robertpuccinelli/PCBs/(commit log)

2018-04-16 initialized repo
    [XC7Z035_universal.kicad_pcb, XC7Z035_universal.sch]
2018-04-21 edited XC7Z035 and biofilms
    [XC7Z035_universal.kicad_pcb, XC7Z035_universal.sch, routing_board.kicad_pcb, routing_board.sch]
2018-04-25 drafted v1 of biofilms PCB
    [routing_board.csv, routing_board.sch]
2018-04-27 finalized v1 of biofilms PCB
    [_saved_routing_board.sch, routing_board.csv, routing_board.kicad_pcb]
2018-05-10 finalized v2 of biofilms PCB
    [_saved_routing_board.sch, adapter_board_BOM_20180427.csv, adapter_board_BOM_20180430.csv, routing_board.csv, routing_board.kicad_pcb, routing_board.sch]
2018-06-18 added in-situ prep pcb
    [in_situ_prep.kicad_pcb, in_situ_prep.sch]
2018-06-25 added capper decapper motor schematic
    [MotorDriverBoard.kicad_pcb, MotorDriverBoard.sch]
2018-09-05 Capper Decapper added with custom components
    [MotorDriverBoard.sch]
2018-09-08 converted to KiCAD 5
    [Capper Decapper.kicad_pcb, Capper Decapper.sch, MotorDriverBoard-2018-09-05-15-03-28.sch, _saved_Capper Decapper.sch]
2018-09-10 complete 1st draft of capper/decapper PCB
    [Capper Decapper.kicad_pcb, Capper Decapper.sch, _saved_Capper Decapper.sch]
2018-09-20 PWM capper decapper board
    [2-Layer PCB-Capper Decapper.kicad_pcb, 4-Layer PCB-Capper Decapper.kicad_pcb, Capper Decapper.kicad_pcb, Capper Decapper.sch, Circuit Simulator.kicad_pcb, Circuit Simulator.sch]
2018-10-05 Capper/Decapper HW Control Board Rev A
    [Capper Decapper.kicad_pcb, Capper Decapper.sch]
2018-10-09 AND gate updated, ordered
    [Capper Decapper.kicad_pcb, Capper Decapper.sch]
2018-12-13 Capper Decapper solenoid correction and solder dispensing files
    [Capper Decapper Solenoid Correction.kicad_pcb, Capper Decapper Solenoid Correction.sch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]
2019-05-16 Directory update
    [Capper Decapper Pneumatics Circuit.kicad_pcb, Capper Decapper Pneumatics Circuit.sch, Capper Decapper.csv, Capper Decapper.sch]
2020-02-26 Update PCBs, Add autocapper board
    [2-Layer PCB-Capper Decapper.kicad_pcb, 4-Layer PCB-Capper Decapper.kicad_pcb, Capper Decapper Pneumatics Circuit.kicad_pcb, Capper Decapper Pneumatics Circuit.sch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]
2020-02-27 Capper Decapper REV B on OSHPark
    [MotorDriverBoard_v2-B_Cu.gbr, MotorDriverBoard_v2-B_Mask.gbr, MotorDriverBoard_v2-B_Paste.gbr, MotorDriverBoard_v2-B_SilkS.gbr, MotorDriverBoard_v2-Edge_Cuts.gbr, MotorDriverBoard_v2-F_Cu.gbr, MotorDriverBoard_v2-F_Mask.gbr, MotorDriverBoard_v2-F_Paste.gbr]
2020-02-28 Update schematic
    [MotorDriverBoard_v2.sch]
2020-03-04 Add printer, global IoT, and Nucelo test boards
    [Laser Proximity Sensor.kicad_pcb, Laser Proximity Sensor.sch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]
2020-03-04 Add capper v2 corrections
    [MotorDriverBoard_v2-B_Cu.gbr, MotorDriverBoard_v2-B_Mask.gbr, MotorDriverBoard_v2-B_Paste.gbr, MotorDriverBoard_v2-B_SilkS.gbr, MotorDriverBoard_v2-Edge_Cuts.gbr, MotorDriverBoard_v2-F_Cu.gbr, MotorDriverBoard_v2-F_Mask.gbr, MotorDriverBoard_v2-F_Paste.gbr]
2020-03-10 Update R1 design files
    [M1_STM32F4.kicad_pcb, M1_STM32F4.sch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]
2020-05-18 Add P1 Rev A, update R1 files, add initial M1, add gerber2graphtec
    [D1_DisplayInterface.sch, D1_ILI6122_FT5446.kicad_pcb, D1_ILI6122_FT5446.sch, D1_SST39VF3201C.sch, D1_STM32F429.sch, M1_STM32F4.kicad_pcb, M1_STM32F4.sch, P1_FT231X.csv]
2020-05-21 P1 Programmer Rev A
    [P1_FT231X.kicad_pcb, P1_FT231X.sch]
2020-05-21 Update LEDs on P1 3D model
    [P1_FT231X.kicad_pcb, P1_FT231X.sch]
2020-05-21 Initial D1, R1 Rev B
    [D1_DisplayInterface.sch, D1_SST39VF3201C.sch, D1_STM32F429.sch, R1_SIM868.kicad_pcb, R1_SIM868.sch]
2020-05-22 Corrected doubled symbol issue on R1
    [R1_SIM868.kicad_pcb, R1_SIM868.sch]
2020-05-24 Update P1 Rev B, R1 Rev B, D1 Rev A
    [D1_DisplayInterface.sch, D1_ILI6122_FT5446.sch, D1_SST39VF3201C.sch, D1_STM32F429.sch, Display_Module.sch, P1_FT231X.kicad_pcb, P1_FT231X.sch, R1.sch]
2020-05-24 R4R: P1 Rev B, R1 Rev B
    [P1_FT231X.kicad_pcb, P1_FT231X.sch, R1_SIM868.kicad_pcb, R1_SIM868.sch]
2020-05-27 R4R D1 Rev A
    [D1_DisplayInterface.sch, D1_ILI6122_FT5446.kicad_pcb, D1_ILI6122_FT5446.sch, D1_SST39VF3201C.sch, D1_STM32F429.sch]
2020-05-30 Ordered: D1 Rev A, R1 Rev B, P1 Rev B
    [D1_DisplayInterface.sch, D1_ILI6122_FT5446.csv, D1_ILI6122_FT5446.kicad_pcb, D1_ILI6122_FT5446.sch, D1_SST39VF3201C.sch, D1_STM32F429.sch, M1_STM32F4.sch, P1_FT231X.csv]
2020-06-06 M1 Rev A, minor component changes in schematic
    [D1_DisplayInterface.sch, D1_ILI6122_FT5446.sch, D1_SST39VF3201C.sch, D1_STM32F429.sch, M1_STM32F0.csv, M1_STM32F0.kicad_pcb, M1_STM32F0.sch, M1_STM32F4.kicad_pcb]
2020-07-28 Move Vespucci and add adc array
    [D1_ILI6122_FT5446.kicad_pcb, M1_STM32F0.kicad_pcb, R1_SIM868.kicad_pcb]
2020-09-28 Add initial DLS design
    [DLSSensorModule.kicad_pcb, DLSSensorModule.sch]
2020-10-03 Update schematic and board layout, Rev A
    [DLSSensorModule.csv, DLSSensorModule.kicad_pcb, DLSSensorModule.sch]
2020-10-03 Update schematic PDF
2020-10-11 Add initial Pi 3B bare metal code
    [config.txt]
2020-10-25 Add cross compiled RPi files, update Python interface
    [config.txt]
2023-07-14 move pcb designs to seperate repos
    [Capper Decapper Solenoid Correction.kicad_pcb, Capper Decapper Solenoid Correction.sch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]
2024-07-17 Add microfluidics footprints to custom library
